uvmaero/AERO_2022-2023/Rear-Control-Board/rear-control-board-Design/rear-control-board.kicad_pcb

## KiCad design Rear-Control-Board/rear-control-board-Design/rear-control-board.kicad_pcb (2023-02-28)

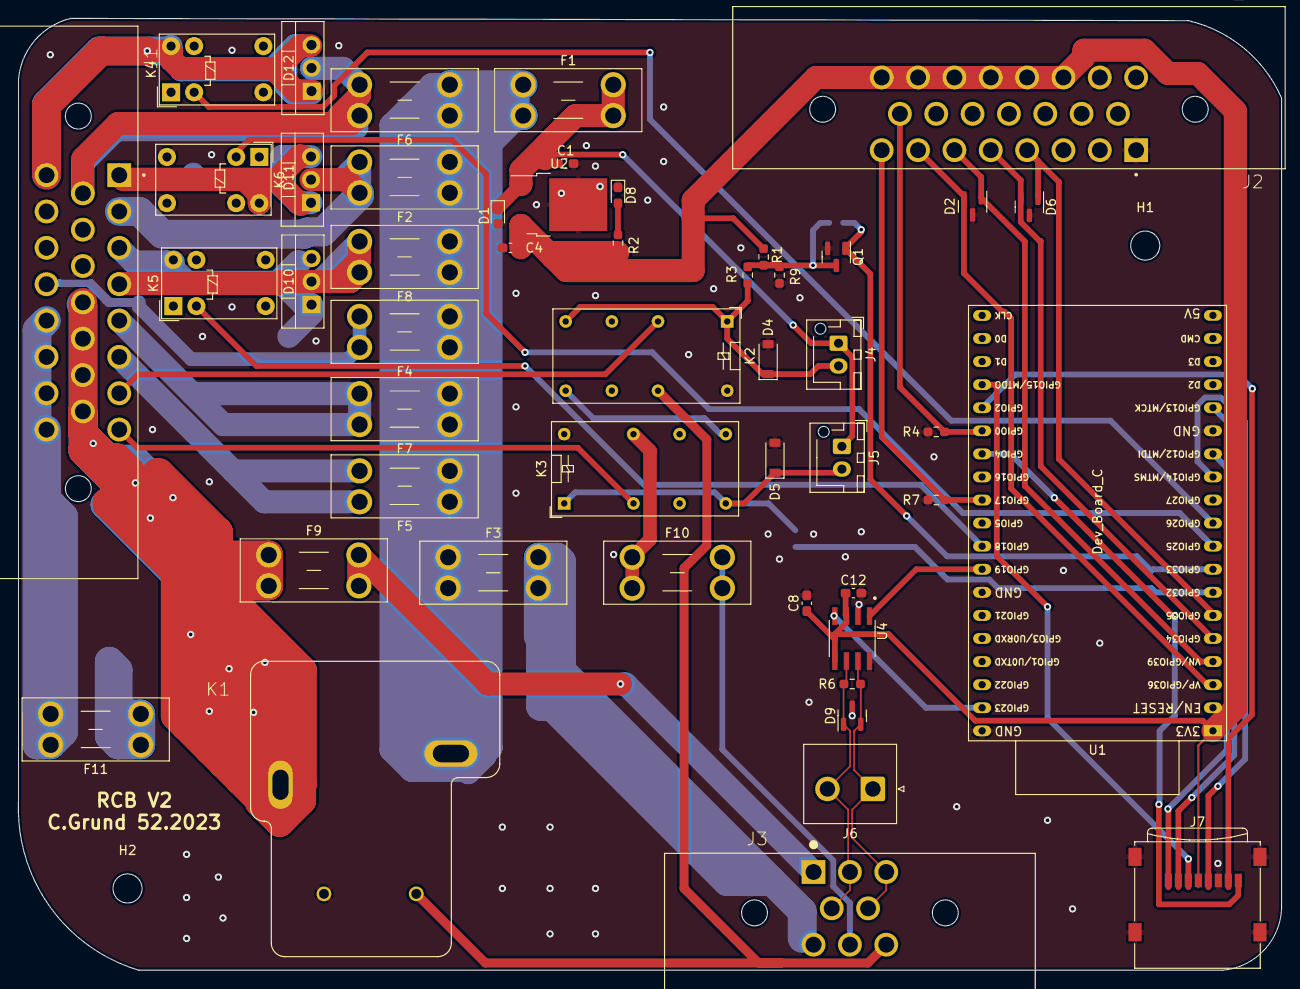
[picture p1: board rear-control-board.kicad_pcb from above]

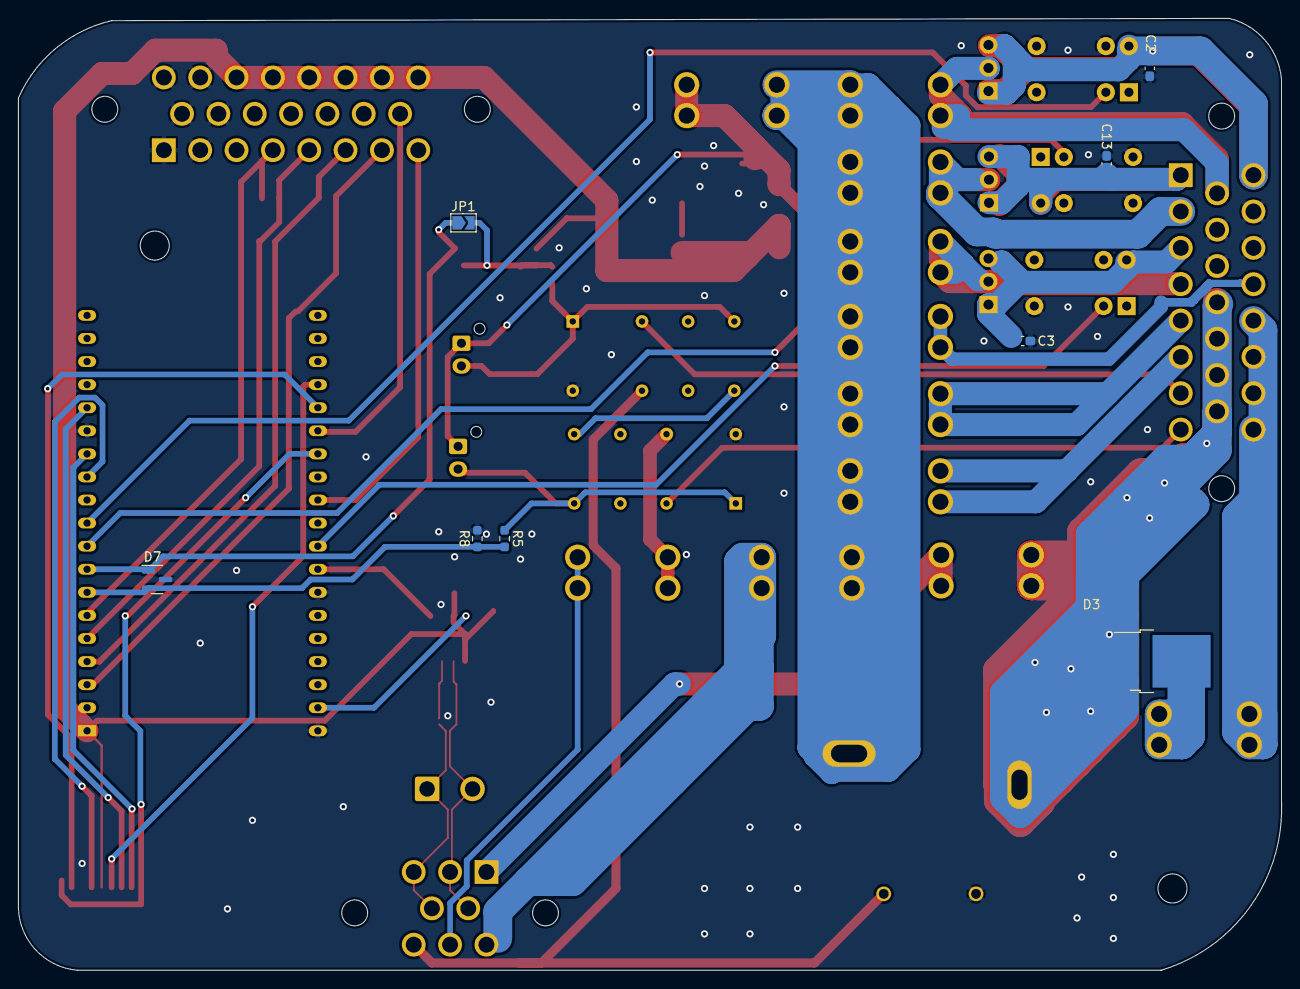
[picture p2: board rear-control-board.kicad_pcb from below]

Board: 2 copper layers, 139.0 x 104.8 mm, 59 parts (8 on the bottom side), 49 nets.

Parts:
C1, C4: 10uF; C_0603_1608Metric_Pad1.08x0.95mm_HandSolder
C2, C3, C13: 1u; C_0603_1608Metric_Pad1.08x0.95mm_HandSolder
C8, C12: 0.1u; C_0603_1608Metric_Pad1.08x0.95mm_HandSolder
D1: TS4148C RZG; D_0603_1608Metric_Pad1.05x0.95mm_HandSolder
D2, D6, D7: SP0502BAHT; SOT-23
D3: D_KAK; TO-252-2
D4, D5: 1N4148; D_SOD-123
D8: LED; LED_0603_1608Metric_Pad1.05x0.95mm_HandSolder
D9: DESD2CAN2SOQ-7; SOT-23
D10, D11, D12: FERD20M60ST; TO-220-3_Vertical
F1, F4, F8, F10: 2A; Fuseholder_Blade_Mini_Keystone_3568
F2: 10A; Fuseholder_Blade_Mini_Keystone_3568
F3, F6: 15A; Fuseholder_Blade_Mini_Keystone_3568
F5, F7: 5A; Fuseholder_Blade_Mini_Keystone_3568
F9: 1A; Fuseholder_Blade_Mini_Keystone_3568
F11: 20A; Fuseholder_Blade_Mini_Keystone_3568
H1, H2: MountingHole; MountingHole_3.2mm_M3
J1, J2: Conn_01x23; TE_1-770669-1_23pin_Horizontal
J3: Conn_01x08; TE_1-776280-1_8pin_Horizontal
J4, J5: JST-B2B-VERT-2PIN; JST_XH_B2B-XH-AM_1x02_P2.50mm_Vertical
J6: Conn_01x02; JST_NV_B02P-NV_1x02_P5.00mm_Vertical
J7: Micro_SD_Card; microSD_HC_Wuerth_693072010801
JP1: SolderJumper_2_Open; SolderJumper-2_P1.3mm_Open_TrianglePad1.0x1.5mm
K1: T9VV1K15-12S; RELAY_T9VV1K15-12S
K2, K3: G5V-2; Relay_DPDT_Omron_G5V-2
K4, K5, K6: G5V-1; Relay_SPDT_Omron_G5V-1
Q1: 2N7002; SOT-23
R1: 100k; R_0603_1608Metric_Pad0.98x0.95mm_HandSolder
R2: 330; R_0603_1608Metric_Pad0.98x0.95mm_HandSolder
R3, R5: 10K; R_0603_1608Metric_Pad0.98x0.95mm_HandSolder
R4, R7: 1k; R_0603_1608Metric_Pad0.98x0.95mm_HandSolder
R6: 120; R_0603_1608Metric_Pad0.98x0.95mm_HandSolder
R8, R9: 2.2K; R_0603_1608Metric_Pad0.98x0.95mm_HandSolder
U1: Dev_Board_C; ESP32-DevKitC
U2: TS2940CP33_ROG; TO-252-2
U4: MAX33054EASA+T; SOIC127P600X175-8N

Connections:
+12V: F1.1, F2.1, F3.1, F4.1, F5.1, F6.1, F7.1, F8.1, K1.4
/BRAKE_12V: D10.2 (K), F8.2, J1.4
/BRAKE_RTRN_12V: C3.1, D10.1 (A), J1.3, K5.10
/BRB_LOOP: F9.2, J3.1
/BRB_RTN: J3.8, K1.1, K2.13
/CAN_N: D9.1 (K), J3.2, J3.4, J6.2, R6.2, U4.6 (CANL)
/CAN_P: D9.2 (K), J3.3, J3.5, J6.1, R6.1, U4.7 (CANH)
/Controller/BRAKE_CTRL: K6.2, U1.9 (DAC_1/ADC2_CH8/GPIO25)
/Controller/CAN_MISO: U1.31 (GPIO19), U4.1 (TXD)
/Controller/CAN_MOSI: U1.37 (GPIO23), U4.4 (RXD)
/Controller/CLK: J7.5 (CLK), U1.12 (MTMS/GPIO14/ADC2_CH6)
/Controller/CMD: J7.3 (CMD), U1.23 (*MTDO/GPIO15/ADC2_CH3)
/Controller/DAT0: J7.7 (DAT0), U1.24 (ADC2_CH2/*GPIO2)
/Controller/DAT1: J7.8 (DAT1), U1.26 (ADC2_CH0/GPIO4)
/Controller/DAT2: J7.1 (DAT2), U1.13 (*MTDI/GPIO12/ADC2_CH5)
/Controller/DAT3: J7.2 (DAT3/CD), U1.15 (MTCK/GPIO13/ADC2_CH4)
/Controller/FAN_CTRL: K4.2, U1.10 (DAC_2/ADC2_CH9/GPIO26)
/Controller/FAULT_BMS: D7.1 (K), JP1.1 (A), Q1.1 (G), U1.8 (32K_XN/GPIO33/ADC1_CH5)
/Controller/FAULT_IMD: D7.2 (K), R5.2, R8.1, U1.7 (32K_XP/GPIO32/ADC1_CH4)
/Controller/PUMP_CTRL: K5.2, U1.30 (GPIO18)
/DCDC_IN: F11.2, J1.20, J1.21, J1.22, J1.23
/FAN_12V: D11.2 (K), F2.2, J1.2
/FAN_RTRN_12V: C13.1, D11.1 (A), J1.1, K6.10
/FAULT_BMS: J1.7, K2.4
/FAULT_IMD: J1.8, K3.4
/FAULT_LATCHER/IMD_SWITCH: D5.1 (K), J5.2, K3.1, K3.8, R5.1
/FRONT_12: F4.2, J1.19
/HVB_12: F7.2, J1.5
/PUMP_12V: D12.2 (K), F6.2, J1.9
/PUMP_RTRN_12V: C2.1, D12.1 (A), J1.16, K4.10
/RINE_12: F3.2, J3.6
/SSOK: F10.1, K3.13
/SUSPENSION_L: D6.2 (K), J2.5, U1.5 (VDET_1/GPIO34/ADC1_CH6)
/SUSPENSION_R: D6.1 (K), J2.4, U1.6 (VDET_2/GPIO35/ADC1_CH7)
/TSV: F10.2, J3.7
/WATER_IN-: J2.8, R7.1, U1.28 (GPIO17)
/WATER_OUT-: J2.15, R4.1, U1.25 (*GPIO0/BOOT/ADC2_CH1)
/WHEEL_L: D2.2 (K), J2.7, U1.3 (SENSOR_VP/GPIO36/ADC1_CH0)
/WHEEL_R: D2.1 (K), J2.6, U1.4 (SENSOR_VN/GPIO39/ADC1_CH3)
/charge-controller/dcdc_fuse: D3.2 (A), F11.1
BATT_12: D3.1 (K), D3.3 (K), F9.1, J1.12, J1.13, J1.14, J1.15, K1.3
BMS_12V: F5.2, J1.6
GND: C1.2, C2.2, C3.2, C4.2, C8.2, C12.2, C13.2, D1.2 (A), D2.3 (A), D4.2 (A), D5.2 (A), D6.3 (A), D7.3 (A), D8.1 (K), D9.3 (A), J1.10, J1.11, J1.17, J1.18, J2.1, J2.2, J2.9, J2.10, J2.16, J2.17, J7.6 (VSS), J7.9 (SHIELD), K1.2, K2.16, K3.16, K4.5, K4.6, K4.9, K5.5, K5.6, K5.9, K6.5, K6.6, K6.9, Q1.2 (S), R4.2, R7.2, R8.2, R9.2, U1.14 (GND), U1.32 (GND), U1.38 (GND), U2.2 (GND), U4.2 (GND), U4.8 (STBY)
INT_12V: C1.1, D1.1 (K), F1.2, J4.1, J5.1, U2.1 (VI)
unnamed: D4.1 (K), J4.2, K2.1, K2.8, R3.1
unnamed: D8.2 (A), R2.2
unnamed: JP1.2 (B), Q1.3 (D), R1.2, R3.2, R9.1
unnamed: K2.9, K3.9
VDD: C4.1, C8.1, C12.1, J2.18, J2.19, J2.20, J2.21, J2.22, J2.23, J7.4 (VDD), R1.1, R2.1, U1.1 (3V3), U1.2 (CHIP_PU), U2.3 (Vo), U4.3 (VDD), U4.5 (VL)
