uvmaero/AERO_2022-2023/Documentation/Battery Pack/Battery Pack.kicad_sch

## KiCad design Documentation/Battery Pack/Battery Pack.kicad_sch (2023-02-21)

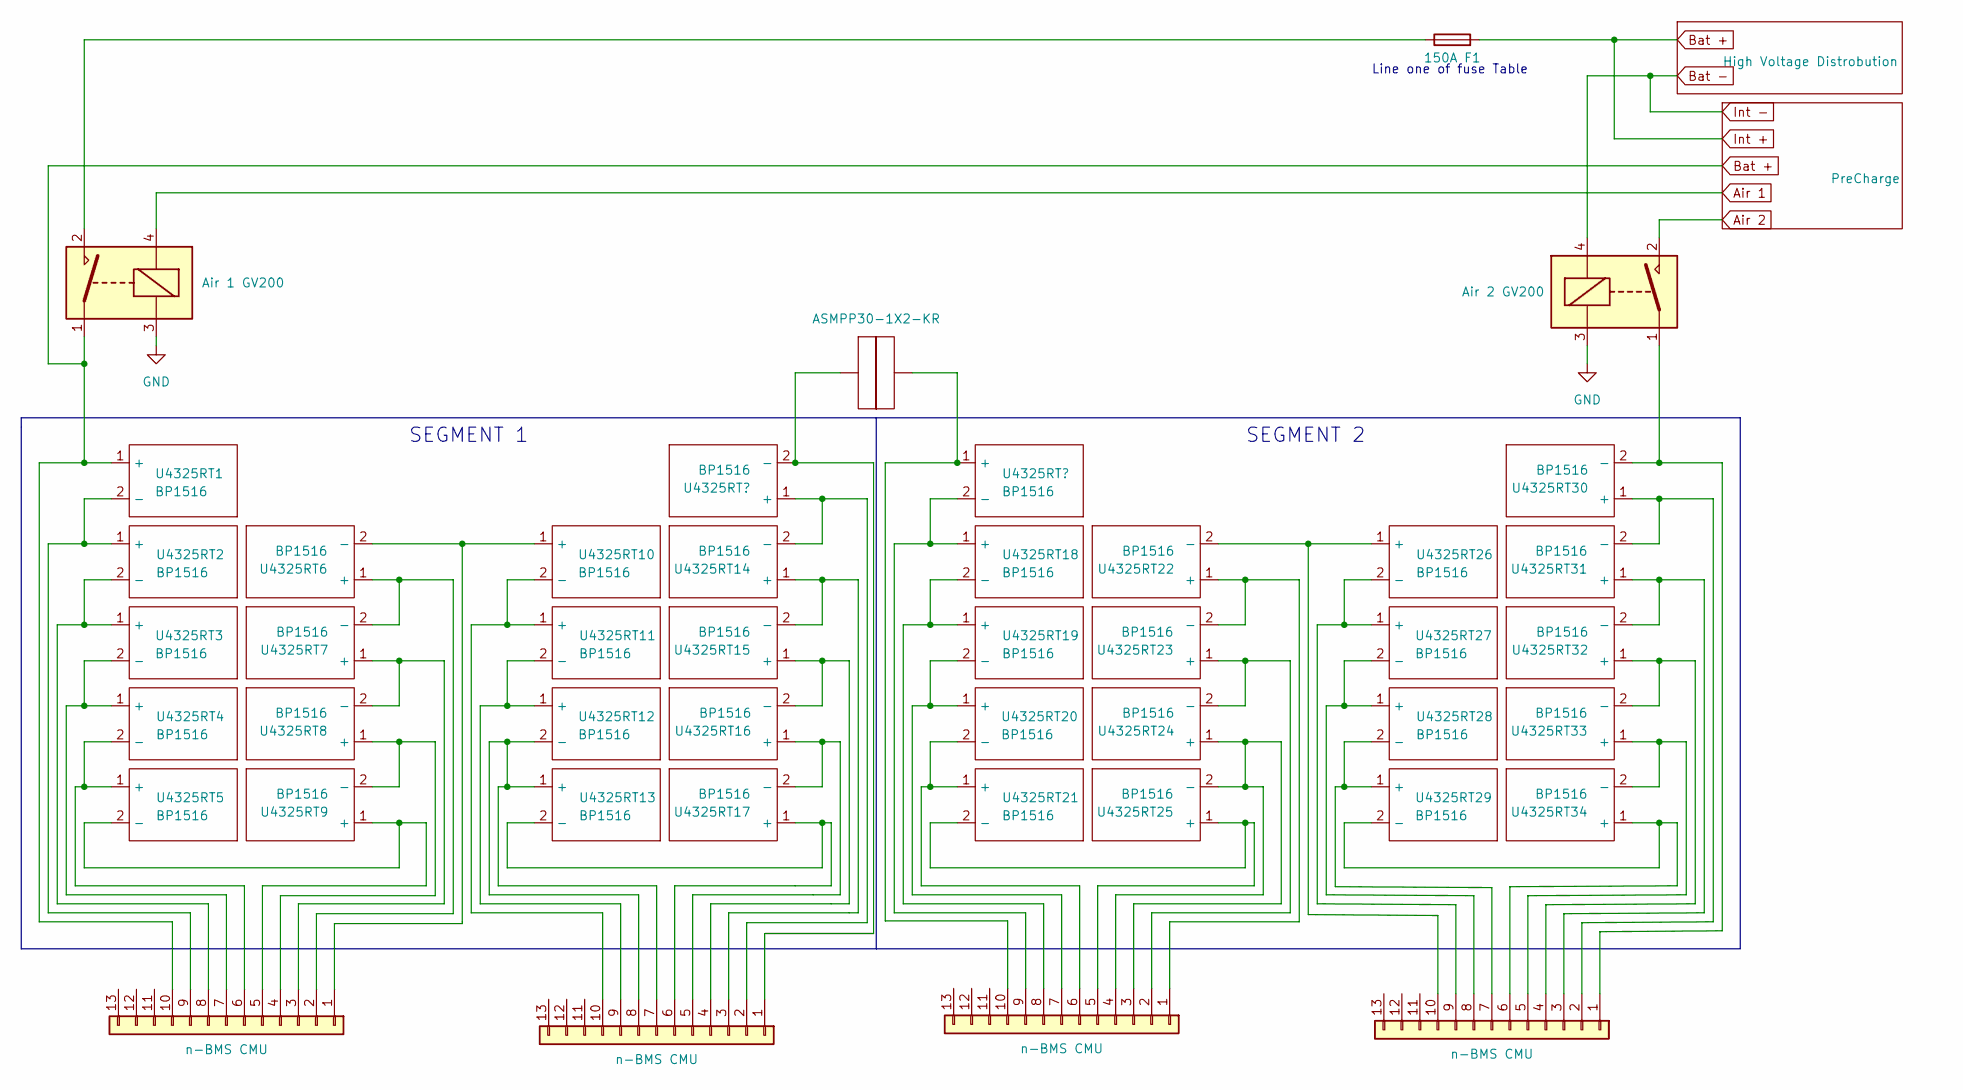
[picture p3: schematic Battery Pack.kicad_sch]

Parts:
K1: Air 1 GV200; Relay_StandexMeder_DIP_LowProfile
K2: Air 2 GV200; Relay_StandexMeder_DIP_LowProfile
P1: ASMPP30-1X2-KR
U4325RT1, U4325RT2, U4325RT3, U4325RT4, U4325RT5, U4325RT6, U4325RT7, U4325RT8, U4325RT9, U4325RT10, U4325RT11, U4325RT12, U4325RT13, U4325RT14, U4325RT15, U4325RT16, U4325RT17, U4325RT18, U4325RT19, U4325RT20, U4325RT21, U4325RT22, U4325RT23, U4325RT24, U4325RT25, U4325RT26, U4325RT27, U4325RT28, U4325RT29, U4325RT30, U4325RT31, U4325RT32, U4325RT33, U4325RT34: BP1516

Connections:
Air 1: K1.4
Air 2: K2.2, K2.8
Bat +: K1.1, K1.14, U4325RT1.1 (+)
Bat -: K2.4
GND: K1.3, K2.3
unnamed: K1.2, K1.8
unnamed: K2.1, K2.14, U4325RT30.2 (-)
unnamed: U4325RT1.2 (-), U4325RT2.1 (+)
unnamed: U4325RT2.2 (-), U4325RT3.1 (+)
unnamed: U4325RT3.2 (-), U4325RT4.1 (+)
unnamed: U4325RT4.2 (-), U4325RT5.1 (+)
unnamed: U4325RT5.2 (-), U4325RT9.1 (+)
unnamed: U4325RT6.1 (+), U4325RT7.2 (-)
unnamed: U4325RT7.1 (+), U4325RT8.2 (-)
unnamed: U4325RT8.1 (+), U4325RT9.2 (-)
unnamed: U4325RT6.2 (-), U4325RT10.1 (+)
unnamed: U4325RT10.2 (-), U4325RT11.1 (+)
unnamed: U4325RT11.2 (-), U4325RT12.1 (+)
unnamed: U4325RT12.2 (-), U4325RT13.1 (+)
unnamed: U4325RT13.2 (-), U4325RT17.1 (+)
unnamed: U4325RT14.1 (+), U4325RT15.2 (-)
unnamed: U4325RT15.1 (+), U4325RT16.2 (-)
unnamed: U4325RT16.1 (+), U4325RT17.2 (-)
unnamed: U4325RT18.2 (-), U4325RT19.1 (+)
unnamed: U4325RT19.2 (-), U4325RT20.1 (+)
unnamed: U4325RT20.2 (-), U4325RT21.1 (+)
unnamed: U4325RT21.2 (-), U4325RT25.1 (+)
unnamed: U4325RT22.1 (+), U4325RT23.2 (-)
unnamed: U4325RT22.2 (-), U4325RT26.1 (+)
unnamed: U4325RT23.1 (+), U4325RT24.2 (-)
unnamed: U4325RT24.1 (+), U4325RT25.2 (-)
unnamed: U4325RT26.2 (-), U4325RT27.1 (+)
unnamed: U4325RT27.2 (-), U4325RT28.1 (+)
unnamed: U4325RT28.2 (-), U4325RT29.1 (+)
unnamed: U4325RT29.2 (-), U4325RT34.1 (+)
unnamed: U4325RT30.1 (+), U4325RT31.2 (-)
unnamed: U4325RT31.1 (+), U4325RT32.2 (-)
unnamed: U4325RT32.1 (+), U4325RT33.2 (-)
unnamed: U4325RT33.1 (+), U4325RT34.2 (-)

Notes on the sheet:
Line one of fuse Table
SEGMENT 2
SEGMENT 1
