uvmaero/AERO_2022-2023/(threads)

Thread 4 (2023-02-01):

Wheel Control Board Display Implementation

dom-gasperini, 2023-02-01:
Display functions need to be implemented via the custom interface library. LCD driver library: https://github.com/Bodmer/TFT_eSPI
