uvmaero/AERO_2022-2023/(commit log)

2022-11-11 First commit to back up
    [BoardV1Proto.kicad_sch]
2023-02-06 oops forgot to push for awile
    [Battery Pack.kicad_pcb, Battery Pack.kicad_sch, Controller.kicad_sch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]
2023-02-07 charger schematic
    [Charger.kicad_pcb, Charger.kicad_sch]
2023-02-21 bat pac
    [Battery Pack.kicad_sch]
2023-03-06 removed code
    [Front Board.kicad_pcb, Front Board.kicad_sch, USB-interface.kicad_sch]
